123khg/Robotino/Extender STLs/Blocker Extender.stl

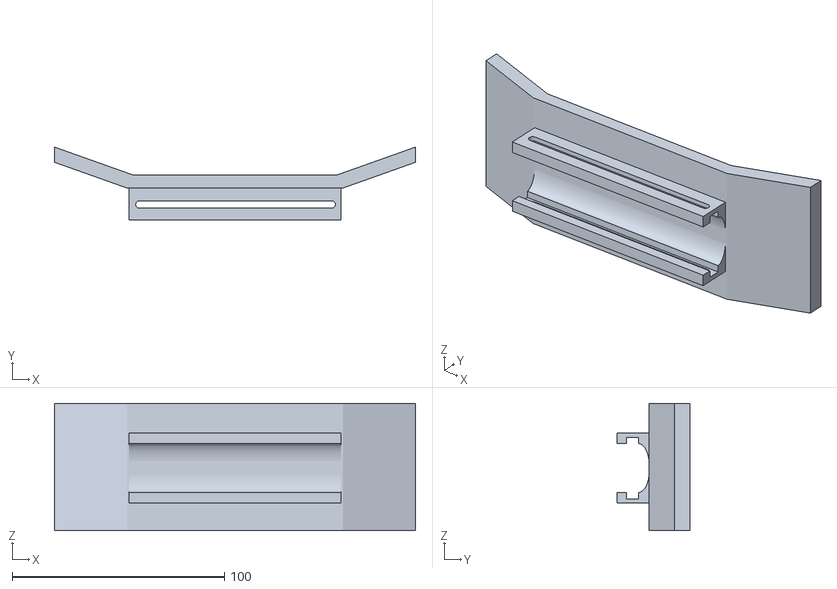
[picture p1: CAD file, 2026-05-05]
Extender STLs/Blocker Extender.stl
170.0 x 34.3 x 60.0
