123khg/Robotino/Extender STLs/Striker Extender.stl

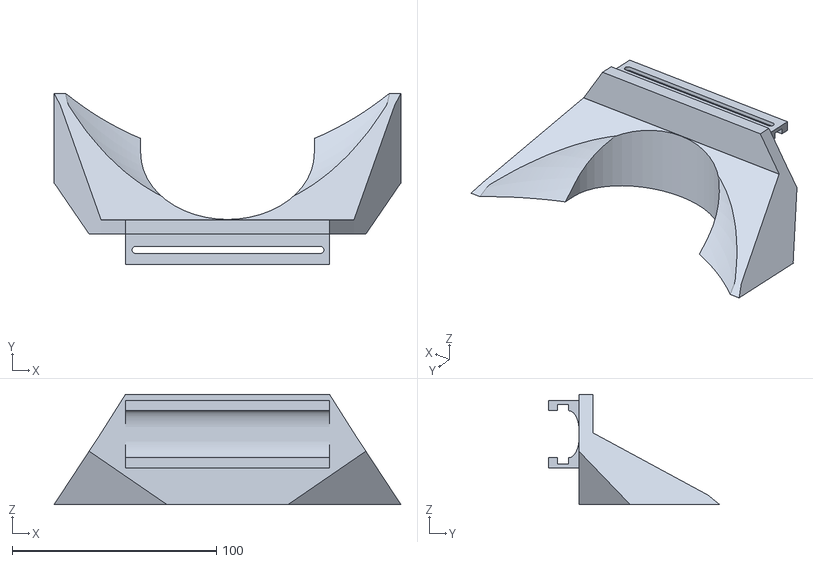
[picture p2: CAD file, 2026-05-05]
Extender STLs/Striker Extender.stl
170.0 x 84.0 x 54.0
