123khg/Robotino/Source_code/Code_Dabble_Sample/Code_Dabble_Sample.ino

#define CUSTOM_SETTINGS
#define INCLUDE_GAMEPAD_MODULE
#include <DabbleESP32.h>

//Right motor
int enableRightMotor = 22; 
int rightMotorPin1 = 16;
int rightMotorPin2 = 17;
//Left motor
int enableLeftMotor = 23;
int leftMotorPin1 = 18;
int leftMotorPin2 = 19;

#define MAX_MOTOR_SPEED 255

const int PWMFreq = 1000; /* 1 KHz */
const int PWMResolution = 8;
const int rightMotorPWMSpeedChannel = 4;
const int leftMotorPWMSpeedChannel = 5;


#define PHONE_ORIENTATION_PORTRAIT

void rotateMotor(int rightMotorSpeed, int leftMotorSpeed)
{
  if (rightMotorSpeed < 0)
  {
    digitalWrite(rightMotorPin1, LOW);
    digitalWrite(rightMotorPin2, HIGH);    
  }
  else if (rightMotorSpeed > 0)
  {
    digitalWrite(rightMotorPin1, HIGH);
    digitalWrite(rightMotorPin2, LOW);      
  }
  else
  {
    digitalWrite(rightMotorPin1, HIGH);
    digitalWrite(rightMotorPin2, HIGH);      
  }
  
  if (leftMotorSpeed < 0)
  {
    digitalWrite(leftMotorPin1, LOW);
    digitalWrite(leftMotorPin2, HIGH);    
  }
  else if (leftMotorSpeed > 0)
  {
    digitalWrite(leftMotorPin1, HIGH);
    digitalWrite(leftMotorPin2, LOW);      
  }
  else
  {
    digitalWrite(leftMotorPin1, LOW);
    digitalWrite(leftMotorPin2, LOW);      
  }
  
  ledcWrite(rightMotorPWMSpeedChannel, abs(rightMotorSpeed));
  ledcWrite(leftMotorPWMSpeedChannel, abs(leftMotorSpeed));  
}

void setUpPinModes()
{
  pinMode(enableRightMotor, OUTPUT);
  pinMode(rightMotorPin1, OUTPUT);
  pinMode(rightMotorPin2, OUTPUT);
  
  pinMode(enableLeftMotor, OUTPUT);
  pinMode(leftMotorPin1, OUTPUT);
  pinMode(leftMotorPin2, OUTPUT);

  //Set up PWM for speed
  ledcSetup(rightMotorPWMSpeedChannel, PWMFreq, PWMResolution);
  ledcSetup(leftMotorPWMSpeedChannel, PWMFreq, PWMResolution);  
  ledcAttachPin(enableRightMotor, rightMotorPWMSpeedChannel);
  ledcAttachPin(enableLeftMotor, leftMotorPWMSpeedChannel); 

  rotateMotor(0, 0); 
}

void setup()
{
  setUpPinModes();
  Dabble.begin("MyBluetoothCar"); 
  // Có thể thêm độ trễ nhỏ để đảm bảo kết nối ổn định
  delay(500);
}

void loop()
{
  int rightMotorSpeed = 0;
  int leftMotorSpeed = 0;
  
  Dabble.processInput();
  
  
  if (GamePad.isLeftPressed()) 
  {
    rightMotorSpeed = MAX_MOTOR_SPEED;
    leftMotorSpeed = 0; // Quay trái
  }
  
  
  if (GamePad.isRightPressed()) 
  {
    rightMotorSpeed = 0;
    leftMotorSpeed = -MAX_MOTOR_SPEED; // Quay phải
  }
  
  
  if (GamePad.isDownPressed()) // 
  {
    rightMotorSpeed = -MAX_MOTOR_SPEED;
    leftMotorSpeed = -MAX_MOTOR_SPEED; // Drift
  }
  
  
  if (GamePad.isUpPressed()) 
  {
    rightMotorSpeed = MAX_MOTOR_SPEED;
    leftMotorSpeed = -MAX_MOTOR_SPEED; // Tiến
  }

  // Nếu muốn thêm điều khiển dừng khi không nhấn phím nào
  // (code hiện tại đã xử lý bằng cách mặc định speed = 0)
  
  rotateMotor(rightMotorSpeed, leftMotorSpeed);
  
  // Thêm độ trễ nhỏ để tránh đọc phím quá nhanh
  delay(50);
} 
