123khg/Robotino/(commit log)

2026-03-30 đã chỉnh sửa
2026-03-30 Chào cả nhà
2026-03-30 FILE PCB CUA TUI
    [L298N ROBOTINO.kicad_pcb, L298N ROBOTINO.kicad_sch]
2026-03-31 Schematic của tay cầm
    [khang.kicad_sch]
2026-04-01 file kicad có schematic và cả pcb của tay cầm điều khiển
    [TAY ĐIỀU KHIỂN.kicad_pcb, TAY ĐIỀU KHIỂN.kicad_sch]
2026-04-11 ve lai schematic cua tay cam, PCB DNHK da ve on
    [TAY ĐIỀU KHIỂN.kicad_pcb, TAY ĐIỀU KHIỂN.kicad_sch, khang.kicad_sch]
2026-04-14 Nguon L298N date : 14/4/2026
    [L298N ROBOTINO.kicad_pcb, L298N ROBOTINO.kicad_sch, RC Car.kicad_sch]
2026-04-14 Add ESP library and comments on Duy Khang's schem
    [TAY ĐIỀU KHIỂN.kicad_sch, khang.kicad_sch]
2026-04-16 Da noi day xong
    [L298N ROBOTINO.kicad_pcb]
2026-04-17 New PCB ver 2 Edit
    [L298N ROBOTINO.kicad_pcb, L298N ROBOTINO.kicad_sch]
2026-04-17 Khang đã cố gắng hết sức
    [ĐIỀU KHIỂN PRO MAX.kicad_pcb, ĐIỀU KHIỂN PRO MAX.kicad_sch]
2026-04-18 code RC car cũ của Khang tick
2026-04-20 Finished Controller PCB optimization and soldered 2 controllers
    [ĐIỀU KHIỂN PRO MAX.kicad_pcb, ĐIỀU KHIỂN PRO MAX.kicad_sch]
2026-04-22 PCB CHO BOARD HAN
    [L298N ROBOTINO.kicad_pcb, L298N ROBOTINO.kicad_sch]
2026-04-22 Successfully initialized NRF on Controllers. MISO MOSI required for PCB.
    [ĐIỀU KHIỂN PRO MAX.kicad_pcb, ĐIỀU KHIỂN PRO MAX.kicad_sch]
2026-04-23 Finished L298N PCB, added a 74hc14 to reduce gpios required, changed PCB to 4 layers to add extra wiring, fixed footprints, fixed pin labels
    [L298N ROBOTINO.kicad_pcb, L298N ROBOTINO.kicad_sch, RC Car.kicad_sch]
2026-04-25 8:00 PM 25 April Adding 2 source code of Transmitter and Receiver of the normal car, the mecanum and the right pin will be working on
2026-05-05 Modify xe 4 bánh bình thường cho đúng chân
    [H-Bridge.kicad_pcb, H-Bridge.kicad_sch]
2026-05-05 chỉnh sửa mecanum code cho khả năng chạy được và sửa dữ liệu gửi đi
2026-05-05 chỉnh sửa lại mapping joystick bên mecanum và sửa lại code mecanum
2026-05-05 Added 3D models
    [Blocker Extender.stl, Striker Extender.stl]
2026-05-06 Added debug, finished 1 PCB, 1 left to check
2026-05-06 Push để pull về lại
    [H-Bridge.kicad_sch]
2026-05-06 de pull ve
2026-05-06 Refactor Full
    [H-Bridge.kicad_pcb, H-Bridge.kicad_sch, TAY ĐIỀU KHIỂN.kicad_pcb, TAY ĐIỀU KHIỂN.kicad_sch]
2026-05-07 commit lần mém cuối*
2026-05-08 Fixed DRC and added LDO, wires, fixed edge cuts
    [ĐIỀU KHIỂN PRO MAX.kicad_pcb, ĐIỀU KHIỂN PRO MAX.kicad_sch]
2026-10-28 docs: update README with comprehensive system architecture, kinematics, and non-tech guide
2026-10-29 docs: fix LaTeX rendering and clarify Mecanum kinematics in section 3.2A
